richardhosking/pizzatemp/README.md

# pizzatemp
Remote temperature sensing application
