richardhosking/pizzatemp/Remote temperature monitor for pizza ovens.odt

Remote temperature monitor for pizza ovens

Who hasnt been to a pizza night?

Pizza is a universal favourite - best of all made at home in your own pizza oven!

Usually ovens are wood fired – there are various designs, some with open faces, some that can be closed up completely. A well designed oven will retain heat for some hours and may only need a minimal heat source to keep it hot

However, it can be difficult to monitor cooking temperature – ideally it should be 200-220 deg C

With this project you can monitor the oven with your smart phone while you enjoy the company of your dinner guests rather than getting your hands dirty!

It could be used also for other ovens such as kilns

In fact the sensor will cover a wide temperature range with good accuracy and linearity – anywhere from -50 to 500 deg C !

Temperature Monitoring devices.

There are several families of temperature monitoring devices – in brief these can be classified as thermocouples, resistive temperature detectors, thermistor and silicon temperature sensors. (1)

Silicon devices may have inbuilt logic circuitry to interface directly with a microcontroller. They can also have analog outputs. In general however, they are limited to a maximum temperature of 125 deg C which makes them unsuitable for this application where the sensor may have to withstand temperatures of 300 deg C or more.

Similarly thermistors are limited to a maximum temperature of 150 deg C or so.

Thermocouples can withstand high temperatures up to >1000 deg C. They are generally constructed using a bimetallic element which produces a temperature dependent voltage. However, this voltage is highly nonlinear with temperature and relatively small – this means that somewhat complex analogue circuitry is required to condition the output and noise may be an issue.

For our application we have used a resistive temperature detector (RTD). These devices have a variable resistance with temperature. They are constructed using a platinum wire coil or a thin layer of platinum deposited on a ceramic substrate. They are highly accurate and repeatable. They do require some analogue circuitry but this can be relatively simple.

The sensor itself can withstand up to 500 deg C or so and can be remote from any electronics.

Analogue circuitry

The variable resistance of the RTD must be converted to logic level data to be processed in our application.

One approach would be to use a differential opamp to amplify to voltage drop across the RTD when it is excited by a current source in a resistive divider. The output is then converted to digital via an ADC input. (Fig 1) This requires some circuitry for the current source and analogue amplifier. Most processors can convert an analog input to digital but resolution may be limited. Noise may be an issue also. An alternative approach is to use a comparator in a “relaxation oscillator” mode. Here a capacitor is alternately charged and discharged as the comparator switches state around a reference voltage. (Fig 2) The output frequency is inversely proportional to the resistance of the RTD. This has the advantage of simplicity and the output can be designed to interface directly with a digital input on the microcontroller which counts the frequency and converts this to temperature. As the resistance of the sensor changes linearly with temperature, a simple calculation algorithm can be used to derive temperature.

RELAXATION OSCILLATOR

Circuit Description

The relaxation oscillator shown in Figure uses the MAX941 comparator. A comparator is essentially on Operational Amplifier in high gain mode – it compares the voltage at its positive(noninverting) and negative (inverting) inputs. When the voltage at the positive input is higher than the negative, the output of the comparator is at VDD – the positive supply rail. When the voltage at the positive input falls below the negative, the output switches state to be close to the negative rail (in this case Ground).

This circuit provides a relatively simple and inexpensive solution to interface a resistive sensor, such as a RTD to a microcontroller. This circuit requires a single comparator, a capacitor and a few resistors. The oscillator outputs a square wave with a frequency inversely proportional to the sensor resistance. At power-up, the comparator output voltage is close to the positive supply voltage (VDD). Based on the values of R2, R3 and R4, the voltage at VIN+ of the comparator will be approx 2/3 VDD. As the capacitor charges through the RTD which is the feedback resistor in this circuit, the VIN– voltage eventually exceeds VIN+ and the comparator switches with the output now being close to VSS. The VIN+ voltage now is reduced to 1/3 VDD. Now the voltage across the capacitor discharges through R1. When the capacitor voltage falls below the voltage at VIN+, the comparator drives the output up to the positive rail (VDD). Therefore, the comparator swings the output voltage to the rails (VDD and VSS), every time the capacitor voltage passes the trip voltage, thus generating a square wave oscillation. The comparator is a high speed, high gain device so stability may be an issue around the switching point. Both the comparator and resistive divider provide builtin hysteresis to improve stability. The comparator supply VDD is 3.3V so the output can be used to drive a microcontroller directly.

Simplified Equations Assume:

1. Ro/R1 = RTD sensor = 1000 ohms at 0 deg C

resistance increases linearly by 0.385 ohms/deg C

2. R2 = R3 = R4 = R

3. R ≅ 10 x Ro

Design Procedure:

1. Select a desired nominal oscillation frequency fo for the RTD oscillator. In our case we want the microcontroller to have enough time to service an interrupt routine on each cycle to allow frequency counting. We settle on a frequency of approximately 1KHz, which allows 800uS or so for the controller to capture the pulse

2. C1 = 1 / (1.386 Ro fo).

3. Select a comparator with an Output Short Circuit Current which is at least five times greater than the maximum output current to ensure start-up at cold and relatively good accuracy.

IOUT_MAX = VDD / R1_MIN

In our case this gives an output current of approx 3mA

The MAX941 will source 15mA or so at VSS and sink 40mA at VDD which should be sufficient

Relaxation Oscillator Test Results

The oscillation frequency was calculated using fixed discrete resistors to simulate the RTD resistance, R1 and the component values shown in Figure 5. In the original circuit, a 0.68 μF tantalum capacitor was chosen for C1. The circuit uses the MAX941 comparator.

Calculations

Output freq fo = 1/(1.386R1C1)

Factoring for output freq

T = (multiplier/C1)*fo – offset

where T is temp Deg C

multiplier is derived from the initial equation as a starting point

offset converts the temperature to celsius (it would be in Kelvin otherwise)

In practice I derived these figures from experimental measurements – see below

I measured the resistance of the RTD at 1130 Ohms at 30 deg C – this was higher than the nominal figure

I used a capacitor of approx 0.6uF – this made up from parallel capacitors in the junkbox

I then made up test resistances to replace the RTD for various temperatures, 0 100 and 200 deg C – ie approx 1120, 1495 and 1880 ohms

By adjusting the multiplier and offset figures in the code the system can be trimmed to compensate for component variation

Microcontroller

We are using the Arduino MKR1000 series boards which have a builtin WiFi stack to allow us to send data to a web enabled device such as a PC, tablet or smartphone. These are cheap and the code is open source which means it is available to be modified. Arduino have provided a programming environment (IDE) which allows us to program the board via a USB port.

Download the latest version of the Arduino IDE from their website. If you are able and are feeling generous, make a donation to support Open Source Development!

In my case the latest version was 1.8.11. Follow the instructions for installation

In my case I use Linux Mint and these instructions apply to Linux.

Run the install script as a normal user in a terminal in the Arduino installation directory

./install.sh

Ensure that you then run as sudo

./arduino-linux-setup.sh $USER

This will set groups and permissions for the USB ports and allow the board access. Otherwise the computer (in my case Linux) may treat the device connected to the USB port as a Human Interface Device or HID (eg mouse). For security reasons the system will then not allow code to be written to the port. Open the Arduino IDE – you may have to manually create a shortcut to it

Go to Tools => Board=> Boards manager and add the MKR1000. In board manager search for MKR1000 - this will bring up the Arduino SAMD boards (32 bit bit ARM Cortex M0+). Install this board.

Add the WiFi101 Library via Sketch => Include Library => Manage Libraries. Search for WiFi101 and install it.

Select the MKR1000 via Tools => Board

Code

The device can connect to a local wifi router and then serves a simple webpage displaying the temperature data. Using a browser and the appropriate network address the user can access this data from a device with a wifi connection to the network

The code measures the frequency of the output of the comparator and derives a temperature.

Frequency Measurement

This is accomplished by counting the number of transitions on the pin connected to the comparator. The Arduino has code for a set timer eg:

delay(1000);

will stop the processor for 1000msec ie 1 sec

But this approach means that the controller is tied up and no other code can be executed. An alternative is use the function millis() which returns the number of millseconds since controller startup

When current_millis() - start_millis() = 1000 then 1 second has passed since the start of the routine. The transitions are counted using an interrupt routine which is connected to the input pin. When there is a positive transition on the input pin the routine is called which adds one to the frequency counter. At the end of the count period the counter contains the frequency data.

The temperature is then derived using the formula above.

Programming the Board

Plug the board into your PCB USB port.

Upload the code to the board via Sketch => Upload. If all is well the Arduino IDE will display various processor data and the progress of writing to FLASH. If error messages are displayed there will generally be an indication from them what the fault is which will allow debugging. If DEBUGMODE is defined at the top of the main sketch code, a serial port can be opened with Tools => Serial Monitor. This will show the progress of logging onto a local Wifi network, the network address of the board and other data to help debugging. The system will hang in this mode until the port is opened. For normal operation this line is commented out.

Hardware

The MKR1000 has a Lithium Polymer battery interface which allows the battery to be charged via a USB port

I have created a shield to mount the analogue circuitry and RTD detector socket on top of the MKR1000 board. The code, schematics and PCB details are available on GitHub at

https://github.com/richardhosking/pizzatemp

The sensor itself is mounted in a piece of copper tubing with aluminium foil to stop movement, At the end of the tubing I have mounted a 2 pin connector using a small piece of sheet copper. I have used copper to allow the sections to be soldered together using a heavy (100W) soldering iron. The wires from the sensor are led through a hole in the side of the tubing. When I built the pizza oven I left a tube though the brickwork to allow temperature measurement – the sensor tubing fits inside this

PCB Drafting

I used JLPCB which is a Chinese company that will produce Printed Circuit Boards (PCBs) in small quantities for a very reasonable cost if you accept their defaults for board material and thickness. You simply upload the Gerber (plot) files for the board and their website performs an automatic check for various parameters. The boards arrived in 3-4 weeks. For the design itself I used KICAD which is an Open Source PCB drafting program which has been around for many years and will work on all platforms. It has performance for free which approaches expensive commercial offerings costing thousands of dollars. It is clearly still being actively developed. While the program is complex and has a fairly steep learning curve for novices, it is fast and works faultlessly on my latest version of Linux Mint. It has extensive libraries of footprints and component outlines. I highly recommend it for anyone who wants to get seriously involved in designing electronics as a hobbyist or semiprofessional engineer. Using KICAD and a PCB design service, a hobbyist can create complex, commercial grade PCBs at minimal cost.

Reading the Temperature

If all is working correctly, log on to your local wifi network using a PC, tablet or smartphone and open a browser window at the IP address specified by the MKR1000 serial monitor. In my case this was 10.1.1.179.

Voila ! The webpage is minimal but shows the temperature of the sensor ie

“The current Temperature is: 27 degrees C “

I would have liked to have a more complex webpage showing a graph of temperature over time but the MKR1000 code space and processor are too small to allow this. Perhaps a Raspberry Pi or similar could be used as a display and act as the Wifi router for the device – I leave this to readers.

References

1. http://ww1.microchip.com/downloads/en/appnotes/00895a.pdf
2. http://ww1.microchip.com/downloads/en/appnotes/00687c.pdf
3. https://www.arduino.cc/en/Guide/MKR1000
