richardhosking/pizzatemp/pizzatemp-remove_stuff/Kicad/ArduinoThermometer.sch

## KiCad design pizzatemp-remove_stuff/Kicad/ArduinoThermometer.sch (2019-02-25, last stored version)

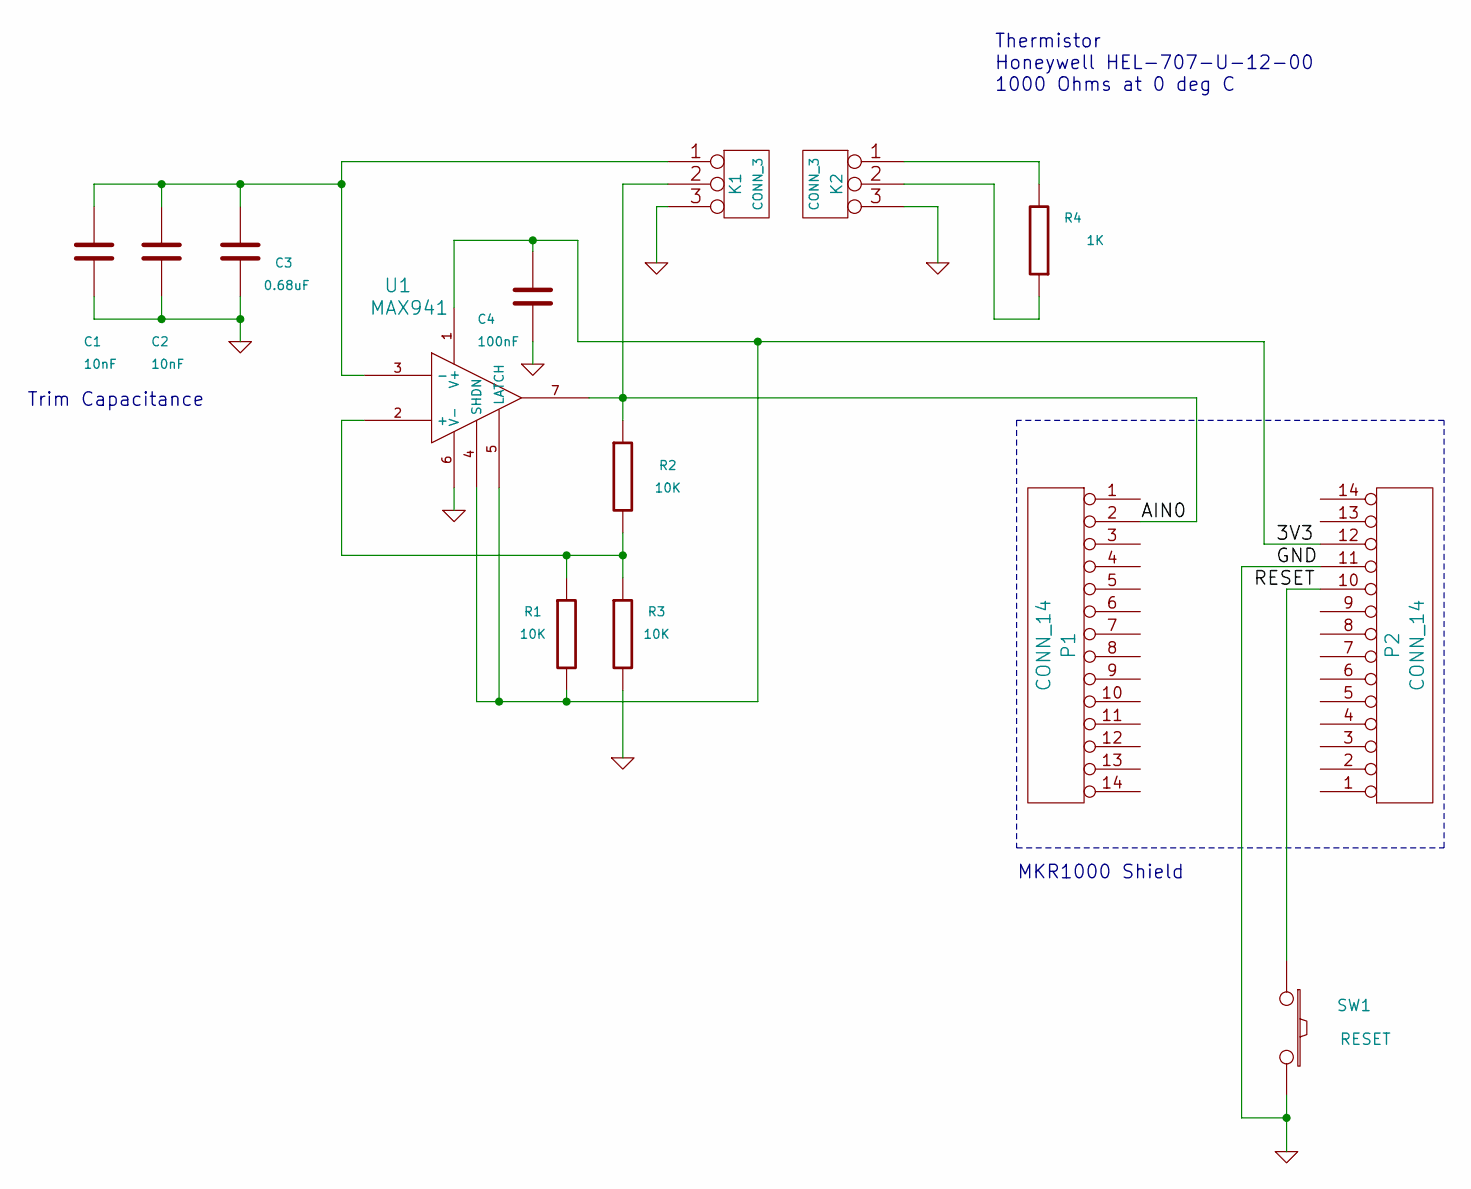
[picture p1: schematic ArduinoThermometer.sch]

Parts:
C1, C2: 10nF
C3: 0.68uF
C4: 100nF
K1, K2: CONN_3
P1, P2: CONN_14
R1, R2, R3: 10K
R4: 1K
SW1: RESET
U1: MAX941

Connections:
3V3: C4.1, P2.12, R1.2, U1.1 (V+), U1.4 (SHDN), U1.5 (LATCH)
AIN0: K1.2 (PM), P1.2, R2.1, U1.7
GND: C1.2, C2.2, C3.2, C4.2, K1.3, K2.3, P2.11, R3.2, SW1.2, U1.6 (V-)
unnamed: C1.1, C2.1, C3.1, K1.1, U1.3 (-)
unnamed: K2.1, R4.2
unnamed: K2.2 (PM), R4.1
unnamed: P2.10, SW1.1
unnamed: R1.1, R2.2, R3.1, U1.2 (+)

Notes on the sheet:
Thermistor Honeywell HEL-707-U-12-00 1000 Ohms at 0 deg C
Trim Capacitance
MKR1000 Shield
