richardhosking/pizzatemp/(commit log)

2018-12-30 Initial commit Arduino sketch and text
2019-02-25 Proof of concept working, schematic drawn, update article
    [ArduinoThermometer.sch]
2019-02-27 still trying delete stuff!
    [ArduinoThermometer.sch]
